SeraphimlabsLLC/Crystal/README.md

# Crystal
ESP32-C3 Wifi adapter for embedded projects

Tested to work with DCC-EX 5.0 using Expressif AT Firmware 3.2 in STA mode. AP mode works but may still have undiscovered issues.
