SeraphimlabsLLC/Crystal/Crystal Shield.pdf

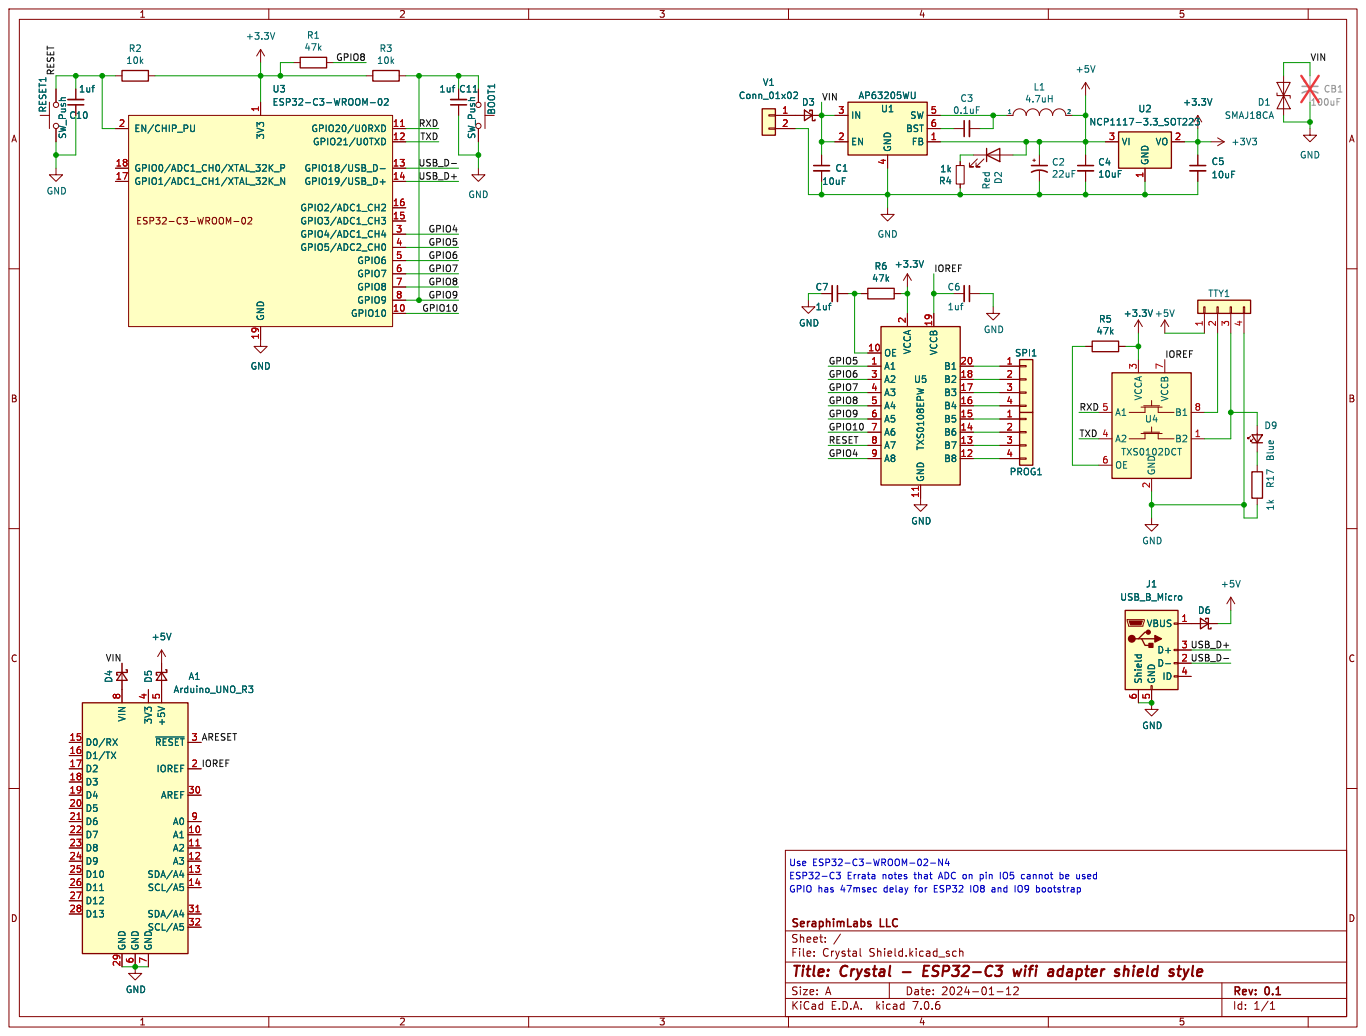
[picture p1: page 1]

ID 4 GND 5 Shield 6 GND

A1 Arduino_UNO_R3 A1 10 A2 11 A3 12 SDA/A4 13 SCL/A5 14 D0/RX 15 D1/TX 16 D2 17 D3 18 D4 19
