SeraphimlabsLLC/Crystal/Crystal.pdf

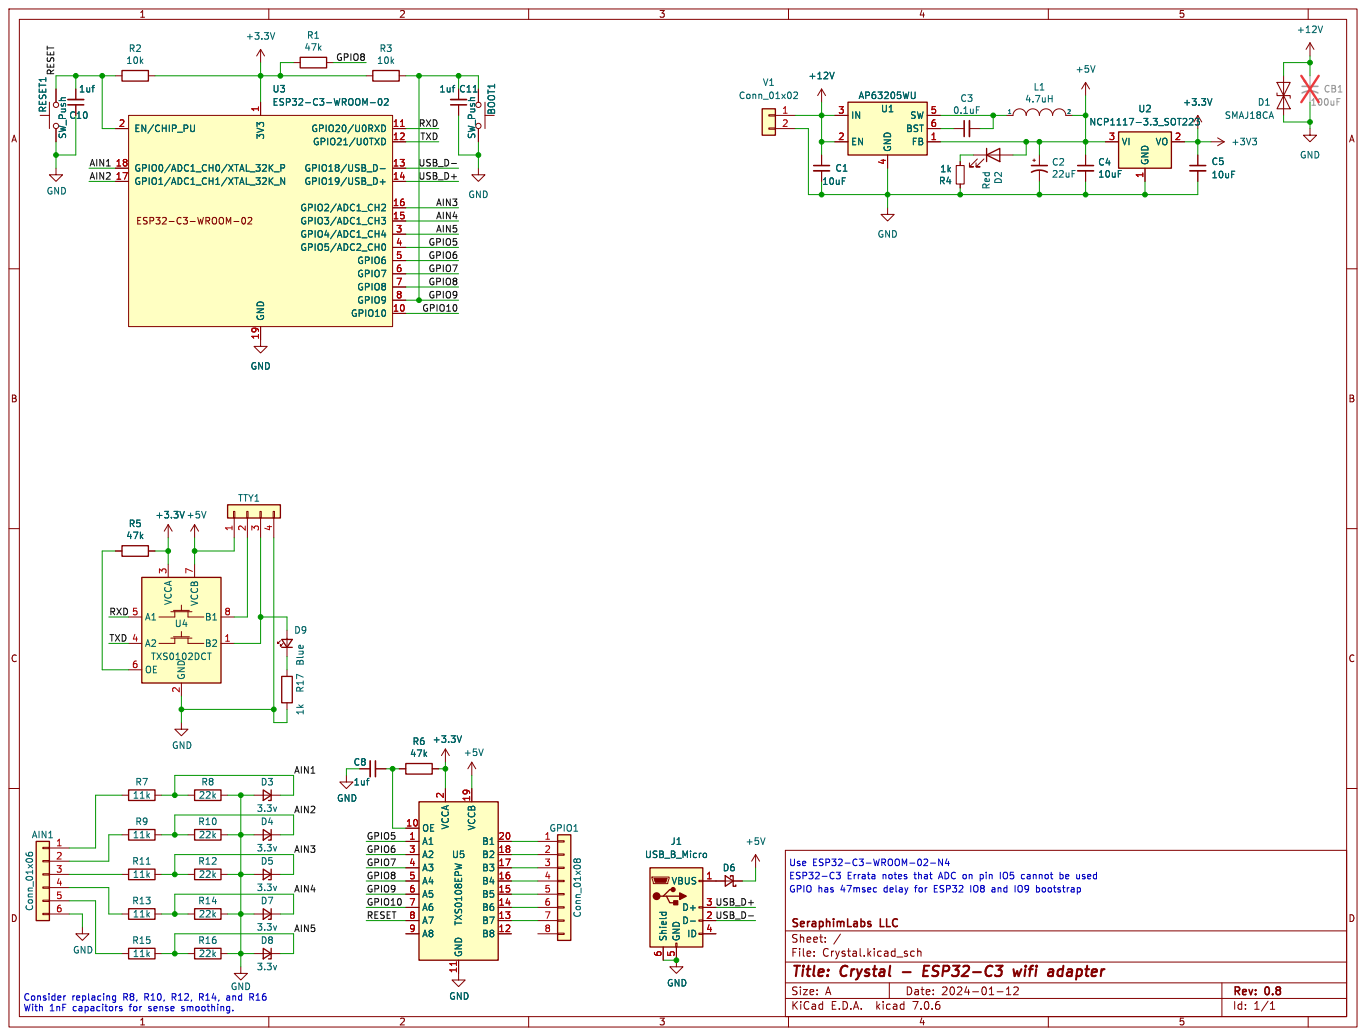
[picture p2: page 1]
