SeraphimlabsLLC/Crystal/Hardware/Crystal/Crystal.kicad_pcb

## KiCad design Hardware/Crystal/Crystal.kicad_pcb (2024-01-13)

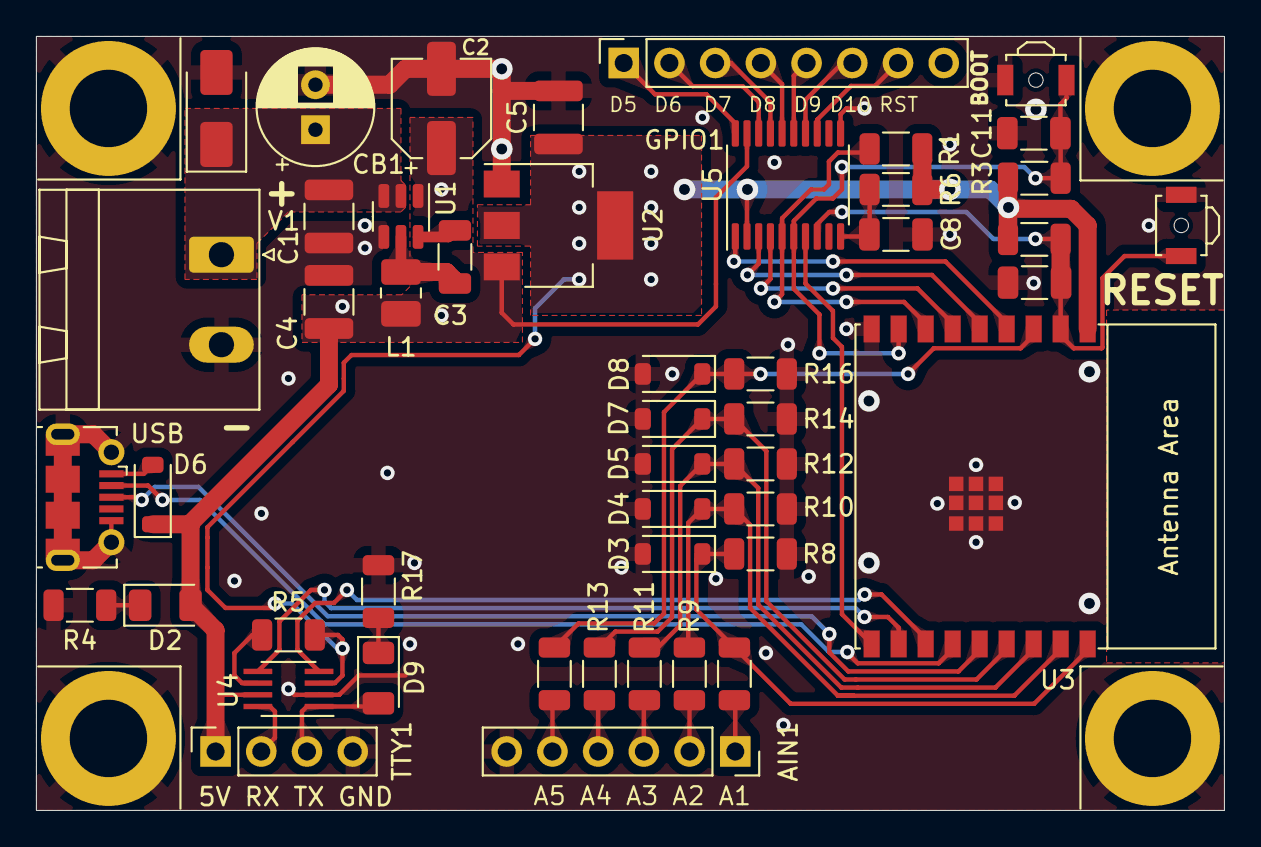
[picture p3: board Crystal.kicad_pcb from above]

Board: 2 copper layers, 66.0 x 43.0 mm, 48 parts (0 on the bottom side), 41 nets.

Parts:
AIN1: Conn_01x06; PinSocket_1x06_P2.54mm_Vertical
BOOT1: SW_Push; SW_SPST_B3U-3000P-B
C1, C4, C5: 10uF; C_1210_3225Metric
C2: 22uF; CP_Elec_5x5.3
C3: 0.1uF; C_1206_3216Metric
C8, C10, C11: 1uf; C_1206_3216Metric
CB1: 100uF; CP_Radial_D6.3mm_P2.50mm
D1: SMAJ18CA; D_SMA
D2: Red; LED_1206_3216Metric
D3, D4, D5, D7, D8: 3.3v; D_SOD-123
D6: PMEG2005EGWX; D_SOD-123
D9: Blue; LED_1206_3216Metric
GPIO1: Conn_01x08; PinSocket_1x08_P2.54mm_Vertical
J1: USB_B_Micro; USB_Micro-B_Molex-105017-0001
L1: 4.7uH; L_1008_2520Metric_Pad1.43x2.20mm_HandSolder
R1, R5, R6: 47k; R_1206_3216Metric
R2, R3: 10k; R_1206_3216Metric
R4, R17: 1k; R_1206_3216Metric
R7, R9, R11, R13, R15: 11k; R_1206_3216Metric
R8, R10, R12, R14, R16: 22k; R_1206_3216Metric
RESET1: SW_Push; SW_SPST_B3U-3000P-B
TTY1: Conn_01x04; PinSocket_1x04_P2.54mm_Vertical
U1: AP63205WU; TSOT-23-6
U2: NCP1117-3.3_SOT223; SOT-223-3_TabPin2
U3: ESP32-C3-WROOM-02
U4: TXS0102DCT; SSOP-8_2.95x2.8mm_P0.65mm
U5: TXS0108EPW; TSSOP-20_4.4x6.5mm_P0.65mm
V1: Conn_01x02; PhoenixContact_MSTBA_2,5_2-G_1x02_P5.00mm_Horizontal

Connections:
+3.3V: C5.1, R1.1, R2.1, R3.1, R5.2, R6.2, U2.2 (VO), U3.1 (3V3), U4.3 (VCCA), U5.2 (VCCA)
+5V: C2.1, C4.1, D2.2 (A), D6.1 (K), L1.2, TTY1.1, U1.1 (FB), U2.3 (VI), U4.7 (VCCB), U5.19 (VCCB)
+12V: C1.1, CB1.1, D1.1 (A1), U1.2 (EN), U1.3 (IN), V1.1
/AIN1: D3.1 (K), R7.1, R8.2, U3.18 (GPIO0/ADC1_CH0/XTAL_32K_P)
/AIN2: D4.1 (K), R9.1, R10.2, U3.17 (GPIO1/ADC1_CH1/XTAL_32K_N)
/AIN3: D5.1 (K), R11.1, R12.2, U3.16 (GPIO2/ADC1_CH2)
/AIN4: D7.1 (K), R13.1, R14.2, U3.15 (GPIO3/ADC1_CH3)
/AIN5: D8.1 (K), R15.1, R16.2, U3.3 (GPIO4/ADC1_CH4)
/GPIO5: U3.4 (GPIO5/ADC2_CH0), U5.1 (A1)
/GPIO6: U3.5 (GPIO6), U5.3 (A2)
/GPIO7: U3.6 (GPIO7), U5.4 (A3)
/GPIO8: R1.2, U3.7 (GPIO8), U5.5 (A4)
/GPIO9: BOOT1.2, C11.2, R3.2, U3.8 (GPIO9), U5.6 (A5)
/GPIO10: U3.10 (GPIO10), U5.7 (A6)
/RESET: C10.2, R2.2, RESET1.2, U3.2 (EN/CHIP_PU), U5.8 (A7)
/RXD: U3.11 (GPIO20/U0RXD), U4.5 (A1)
/TXD: U3.12 (GPIO21/U0TXD), U4.4 (A2)
/USB_D+: J1.3 (D+), U3.14 (GPIO19/USB_D+)
/USB_D-: J1.2 (D-), U3.13 (GPIO18/USB_D-)
GND: AIN1.6, BOOT1.1, C1.2, C2.2, C4.2, C5.2, C8.2, C10.1, C11.1, CB1.2, D1.2 (A2), D3.2 (A), D4.2 (A), D5.2 (A), D7.2 (A), D8.2 (A), J1.5 (GND), J1.6 (Shield), R4.1, R8.1, R10.1, R12.1, R14.1, R16.1, R17.2, RESET1.1, TTY1.4, U1.4 (GND), U2.1 (GND), U3.9 (GND), U3.19 (GND), U4.2 (GND), U5.11 (GND), V1.2
unnamed: AIN1.1, R7.2
unnamed: AIN1.2, R9.2
unnamed: AIN1.3, R11.2
unnamed: AIN1.4, R13.2
unnamed: AIN1.5, R15.2
unnamed: D2.1 (K), R4.2
unnamed: D6.2 (A), J1.1 (VBUS)
unnamed: D9.2 (A), TTY1.3, U4.1 (B2)
unnamed: D9.1 (K), R17.1
unnamed: GPIO1.1, U5.20 (B1)
unnamed: GPIO1.2, U5.18 (B2)
unnamed: GPIO1.3, U5.17 (B3)
unnamed: GPIO1.4, U5.16 (B4)
unnamed: GPIO1.5, U5.15 (B5)
unnamed: GPIO1.6, U5.14 (B6)
unnamed: GPIO1.7, U5.13 (B7)
unnamed: TTY1.2, U4.8 (B1)
unnamed: C3.1, U1.6 (BST)
unnamed: C3.2, L1.1, U1.5 (SW)
unnamed: R5.1, U4.6 (OE)
unnamed: C8.1, R6.1, U5.10 (OE)
