SeraphimlabsLLC/Crystal/(commit log)

2023-07-30 Completed schematic with BOM and PCB layout.
    [Crystal.kicad_pcb, Crystal.kicad_sch]
2023-08-20 Revised L1 for possible 2A output, cleaner fill zones
    [Crystal-B_Cu.gbr, Crystal-B_Mask.gbr, Crystal-B_Paste.gbr, Crystal-B_Silkscreen.gbr, Crystal-Edge_Cuts.gbr, Crystal-F_Cu.gbr, Crystal-F_Mask.gbr, Crystal-F_Paste.gbr]
2023-08-21 Added note about VIN plug, BOM cleanup.
    [Crystal.csv, Crystal.kicad_sch]
2023-09-28 First build using ESP AT Firmware 3.2
    [Crystal-B_Cu.gbr, Crystal-B_Mask.gbr, Crystal-B_Paste.gbr, Crystal-B_Silkscreen.gbr, Crystal-Edge_Cuts.gbr, Crystal-F_Cu.gbr, Crystal-F_Mask.gbr, Crystal-F_Paste.gbr]
2023-12-17 Final cleanup, added tags for JLCPCB Fabrication
    [Crystal.kicad_pcb, Crystal.kicad_sch]
2023-12-18 Swap TX and RX pins on COM port, populate PCBA data in KiCad
    [Crystal-B_Cu.gbr, Crystal-B_Mask.gbr, Crystal-B_Paste.gbr, Crystal-B_Silkscreen.gbr, Crystal-Edge_Cuts.gbr, Crystal-F_Cu.gbr, Crystal-F_Mask.gbr, Crystal-F_Paste.gbr]
2023-12-18 Further board cleanup
    [Crystal-B_Cu.gbr, Crystal-B_Mask.gbr, Crystal-B_Paste.gbr, Crystal-B_Silkscreen.gbr, Crystal-Edge_Cuts.gbr, Crystal-F_Cu.gbr, Crystal-F_Mask.gbr, Crystal-F_Paste.gbr]
2023-12-31 Changed mounting holes to be drilled and plated instead of milled.
    [Crystal-B_Cu.gbr, Crystal-B_Mask.gbr, Crystal-B_Paste.gbr, Crystal-B_Silkscreen.gbr, Crystal-Edge_Cuts.gbr, Crystal-F_Cu.gbr, Crystal-F_Mask.gbr, Crystal-F_Paste.gbr]
2023-12-31 Updated notes on schematic
2024-01-13 PCB Revision for 5mm power plug to match EX-8874
    [Crystal-B_Cu.gbr, Crystal-B_Mask.gbr, Crystal-B_Paste.gbr, Crystal-B_Silkscreen.gbr, Crystal-Edge_Cuts.gbr, Crystal-F_Cu.gbr, Crystal-F_Mask.gbr, Crystal-F_Paste.gbr]
2024-01-13 Further PCB revision to use MLCC caps in the 5v regulator for better smoothing and space utilization
    [Crystal-B_Cu.gbr, Crystal-B_Mask.gbr, Crystal-B_Paste.gbr, Crystal-B_Silkscreen.gbr, Crystal-Edge_Cuts.gbr, Crystal-F_Cu.gbr, Crystal-F_Mask.gbr, Crystal-F_Paste.gbr]
2024-01-13 Added Shield version of Crystal, and support for Wifinina on both versions.
    [Crystal Shield-B_Cu.gbr, Crystal Shield-B_Mask.gbr, Crystal Shield-B_Paste.gbr, Crystal Shield-B_Silkscreen.gbr, Crystal Shield-Edge_Cuts.gbr, Crystal Shield-F_Cu.gbr, Crystal Shield-F_Mask.gbr, Crystal Shield-F_Paste.gbr]
2024-01-30 BOM fix, replace NCP1117 with TLV1117 and add Arduino stacking headers
    [Crystal Shield-B_Cu.gbr, Crystal Shield-B_Mask.gbr, Crystal Shield-B_Paste.gbr, Crystal Shield-B_Silkscreen.gbr, Crystal Shield-Edge_Cuts.gbr, Crystal Shield-F_Cu.gbr, Crystal Shield-F_Mask.gbr, Crystal Shield-F_Paste.gbr]
